akankaan/bf16-fma/(commit log)

2026-07-24 Created bf16_fma_top, which currently is a stub, and wired testbench.
2026-08-03 Added aligner shift directed test case; wrote random and directed test vectors
2026-08-09 Added addsub sticky borrow correction in effective subtraction
    [bf16_addsub.sv]
2026-08-09 Added zero magnitude checking in addsub; prevents borrow underflow when a subtract cancels to zero
    [bf16_addsub.sv]
2026-08-10 Correctly renamed normalizer testbench
    [bf16_normalizer_tb.sv]
2026-08-10 Added negative zero special case since addsub loses sign of zero after two's magnitude conversion
2026-08-10 Added input loader; required as the chip doesn't have enough io pins
    [bf16_loader.sv]
2026-08-12 Added keep_hierarchy tags to identify path delays between between units to make flow result informed pipelining decisions
2026-08-13 Fixed aligner dominance for DAZ-zeroed addend
    [bf16_aligner.sv]
2026-08-14 Added Makefile for easily running testbenches; fixed module instantiation in same name in multiplier testbench
    [bf16_multiplier_tb.sv]
2026-08-15 Added fma directed test case vectors to core and top-level
2026-08-17 Added normalizer directed test case vectors
2026-08-18 Added three stage FMA pipeline
2026-08-18 Changed FMA core testbench to driver-monitor style
2026-08-20 Separated addsub unit and its preparation signals to different pipeline stages
2026-08-20 Moved operand swap from addsub_prepare back to addsub
    [bf16_addsub.sv, bf16_addsub_prepare.sv, bf16_addsub_tb.sv, bf16_fma_core.sv]
2026-08-21 Added pipeline register between decode_classify and multiplier to balance near-critical stages
2026-08-22 Fixed spelling mistakes in comments
    [bf16_aligner.sv, bf16_decode_classify.sv, bf16_fma_tb.sv, bf16_loader.sv, bf16_rounder.sv]
2026-08-26 Added Raspberry PI vector loading and result monitoring
2026-08-26 Added Raspberry PI terminal status dashboard
